ianwu0228/dc_lab_spring_2026/report/latex/figures/coil_driver_chain.jpg

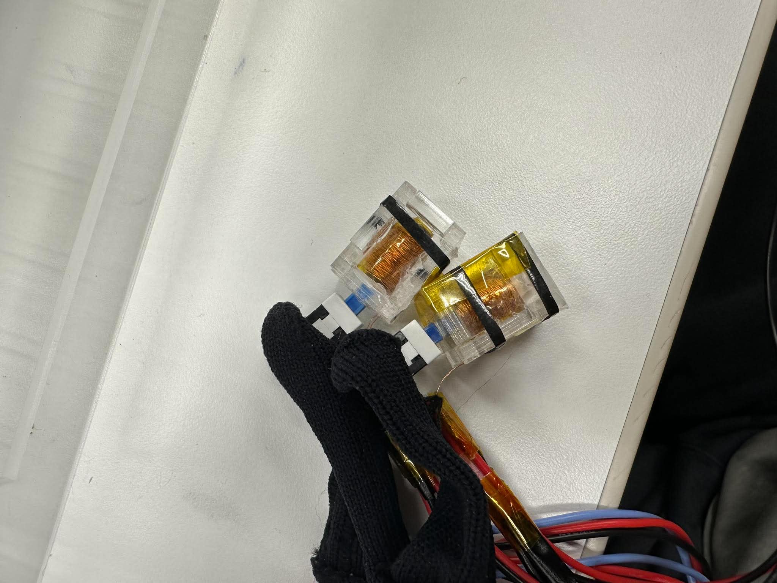
report/latex/figures/coil_driver_chain.jpg
