ianwu0228/dc_lab_spring_2026/report/latex/figures/final_hardware_photo.jpg

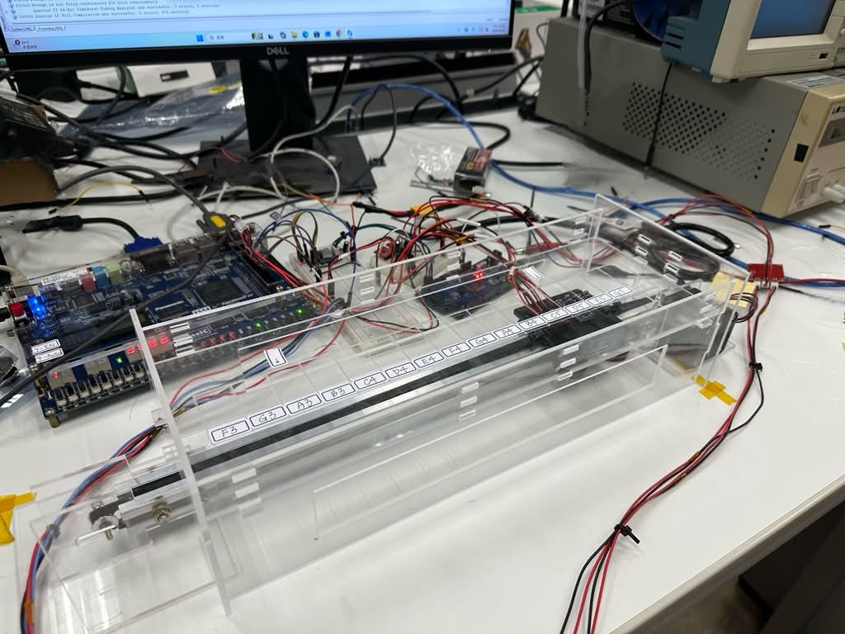
report/latex/figures/final_hardware_photo.jpg
