ianwu0228/dc_lab_spring_2026/report/latex_template/back/appendix01.tex

\section{Supplementary Derivations}
\label{app:supplementary_derivations}

Place longer derivations, additional simulation settings, or supporting tables
here. Keep the main report focused on the design story and move detailed backup
material to the appendix.
