ianwu0228/dc_lab_spring_2026/report/latex_template/contents/01_spec_summary.tex

\section{Specification Summary}
\label{sec:spec_summary}

Summarize the target specifications of Project 2 and report the final simulated
performance after the design is complete. Keep this table as the first technical
checkpoint so readers can quickly compare the requirement and implementation.

\begin{table}[H]
    \centering
    \caption{Project 2 specification summary.}
    \label{tab:spec_summary}
    \renewcommand{\arraystretch}{1.25}
    \begin{tabularx}{0.95\textwidth}{
        >{\raggedright\arraybackslash}X
        >{\centering\arraybackslash}p{3.2cm}
        >{\centering\arraybackslash}p{3.2cm}
        >{\centering\arraybackslash}p{2.4cm}
    }
        \toprule
        \textbf{Specification} & \textbf{Requirement} & \textbf{Result} & \textbf{Status} \\
        \midrule
        Supply voltage & TBD & TBD & TBD \\
        Input range & TBD & TBD & TBD \\
        Output range & TBD & TBD & TBD \\
        Operating frequency & TBD & TBD & TBD \\
        Power consumption & TBD & TBD & TBD \\
        Key performance metric 1 & TBD & TBD & TBD \\
        Key performance metric 2 & TBD & TBD & TBD \\
        \bottomrule
    \end{tabularx}
\end{table}

Briefly explain the most important design trade-offs and any specifications that
are close to the requirement limit.
