ianwu0228/dc_lab_spring_2026/report/latex_template/contents/02_system_architecture.tex

\section{System Architecture}
\label{sec:system_architecture}

Describe the top-level architecture of the Project 2 circuit. State the role of
each major block and explain how signals flow from the input to the output.

\begin{figure}[H]
    \centering
    \fbox{\parbox[c][5cm][c]{0.85\textwidth}{
        \centering
        Replace this box with the top-level architecture figure.
    }}
    \caption{Top-level architecture of the Project 2 design.}
    \label{fig:system_architecture}
\end{figure}

\subsection{Block Overview}

List the main blocks in the system and summarize their functions. For each block,
include the design intent, critical interfaces, and any important assumptions.

\begin{itemize}
    \item \textbf{Block 1:} Describe its purpose and input/output signals.
    \item \textbf{Block 2:} Describe its purpose and input/output signals.
    \item \textbf{Block 3:} Describe its purpose and input/output signals.
\end{itemize}

\subsection{Operation Sequence}

Explain the operating phases, timing sequence, or control flow used by the design.
Use a timing diagram if the project depends on clock phases, reset behavior, or
state transitions.
