ianwu0228/dc_lab_spring_2026/report/latex/magnetic_piano_top_level_architecture.pptx

Top-level System Architecture - Magnetic Piano (75Hz / 45Hz Detection & Auto-Tracking Platform)

FPGA (Intel DE2-115)

QMC5883P Magnetometers

3-axis magnetic sensors
I2C-line interface (GPIO)
Data rate: 200 Hz
Output: 16-bit raw X, Y, Z

1. Sensor Readout (I2C)

qmc5883p_ctrl (x3)

Init & register config
Periodic readout
Data assembly

Raw Data Outputs

mag1_x/y/z
mag2_x/y/z
mag3_x/y/z

2. Calibration

(for average & scale calc)

mag_calibration_manager

Compute offset & radius

Calibration Coefficients

3. Real-time Calibration

mag_calibrator (x3)

Calibrated Outputs

sample_tick

Sample Sync
& Tick

sample_seen
mask

All active
sensors
updated?

carrier_
sample_tick

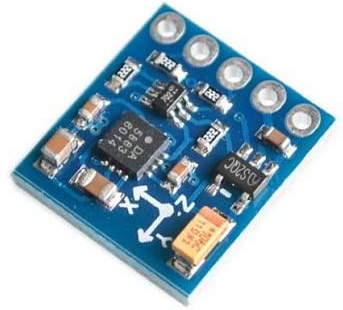
[picture p3: figure]
QMC5883P 3-Axis Compass Magnetometer Sensor Module 3V-5V - QMC5883PMOD

i2c_master (x3)

Raw Data

unsigned_divider

coeff.

Real time
H2 value

PC (Windows)

Python Application
Receive via UART
LUT Collection
Piano Key Monitor
(H2 Frames & KEY Frames)

4. Reference Generators(Fs = 200 Hz)

5. Lock-in Detection (Per-Sensor)

Multiply with sin75/cos75
I/Q accumulation
H2 = X1^2 + Y1^2 + Z1^2

Calibrated field

mag_lockin_vector_75hz (x3)

Multiply with sin45/cos45
I/Q accumulation
H2 = X1^2 + Y1^2 + Z1^2

Outputs

H45_S1,H45_S2, H45_S3

10. UART Streaming to PC

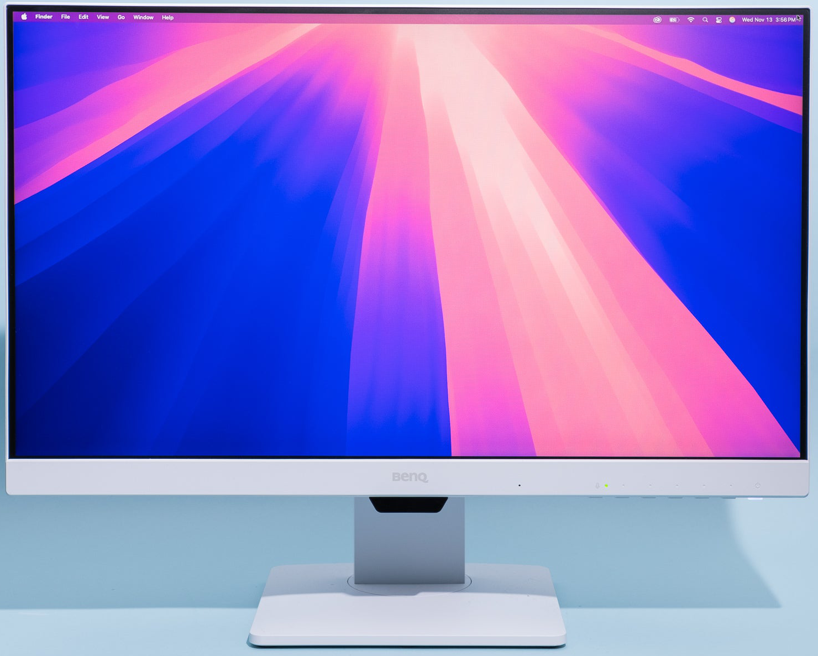
[picture p4: figure]
The 8 Best Monitors of 2026 | Reviews by Wirecutter

Reference-75hz

75 Hz = 3/8 cycle
8-entry LUT

Reference_45hz

45 Hz =9/40 cycle
40-entry LUT

mag_lockin_vector_75hz (x3)

Outputs

H75_S1, H75_S2, H75_S3

UART_TXD

Press Buttons (Active-High)

Button 0 –
75Hz Note
-> GPIO[11]

Button 1 –
45Hz Note
-> GPIO[12]

Debounced (10 ms)
Sent to PC as press state

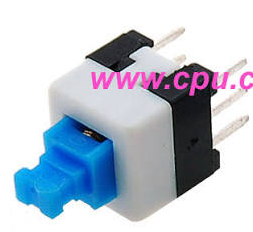
[picture p5: figure]
KPA-2203A 7x7mm 6P無段按鍵開關| 廣華電子

GPIO[11]
GPIO[12]

Outputs

sin75_q15
cos75_q15

Outputs

sin45_q15
cos45_q15

H2 frames

sin/cos q15

6. H2 Frame Averaging (Noise Smoothing)

7. LUT-based Classification (Per Frequency)

h2_lut_classifier_3sensor

Compute ratios
Compare with LUT ROM

key75_id, key75_score, key75_valid
key45_id, key45_score, key45_valid

8. Platform Tracker (Auto-Follow)

Decision:
sum <= -2 -> move left
sum >= +2 -> move right
otherwise -> stay
Boundary check (K2 ~ K12)
Stable confirmation & cooldown

9. Stepper Control (FPGA)

stepper_drv8825_controller

Outputs

Step/DIR/EN

DRV8825
Stepper Driver

Microstep (1/16)
VMOT / GND
A1/A2, B1/B2

h2_average_3sensor
(for 75Hz)

h2_average_3sensor
(for 45Hz)

avg_H2

unsigned_divider

Outputs

key75/key45

STEP / DIR
EN

LUT

Stepper Motor
(NEMA17)

Display & Debug (On FPGA)

Show raw/calibrated values, H2 (75/45), keys, platform center, status

VGA

LCD 16x2

7-Segment HEX

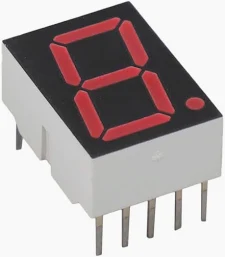
[picture p6: figure]

LEDR

LEDG

FPGA External Interface Summary

I2C-like (GPIO):
SCL1/SDA1 -> Sensor #1
SCL2/SDA2 -> Sensor #2
SCL3/SDA3 -> Sensor #3
Buttons: GPIO[11] (75Hz), GPIO[12] (45Hz)
Stepper Driver: GPIO[8] STEP, GPIO[9] DIR, GPIO[10] ENABLE_N
UART: RS232 TXD -> PC (115200 bps)

LUT Memory Files

Stored in FPGA ROM via .mem files
h75_lut_3sensor.
h45_lut_3sensor.mem

Legend

Data Path

Control / Timing

Power / Mechanical

Sliding Platform / Bottom

Moves Left <-> Right

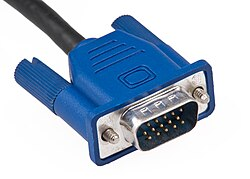
[picture p7: figure]
VGA端子- 維基百科，自由的百科全書
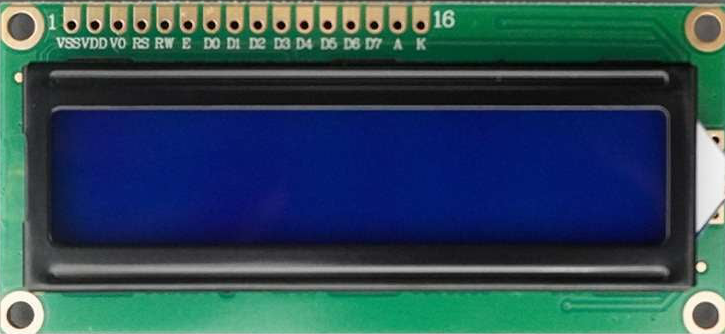
[picture p8: figure]
Sensors Modules Lcd 16x2 Display Module | Sensors Modules

Motor Control

UART
