ianwu0228/dc_lab_spring_2026/team07_final/presentation_slides.pdf

# DCLab Final

# Magnetic Field Finger-Tracking Musical Glove

2026 Spring

### Group 7 電機四 B11202010 韓裕民、B11901188 吳毅恩、B11901193 劉又慈

## - Hardware Implementation

## - FPGA System Architecture

## - Filtering Strategy

## - Key Classification

# Outline

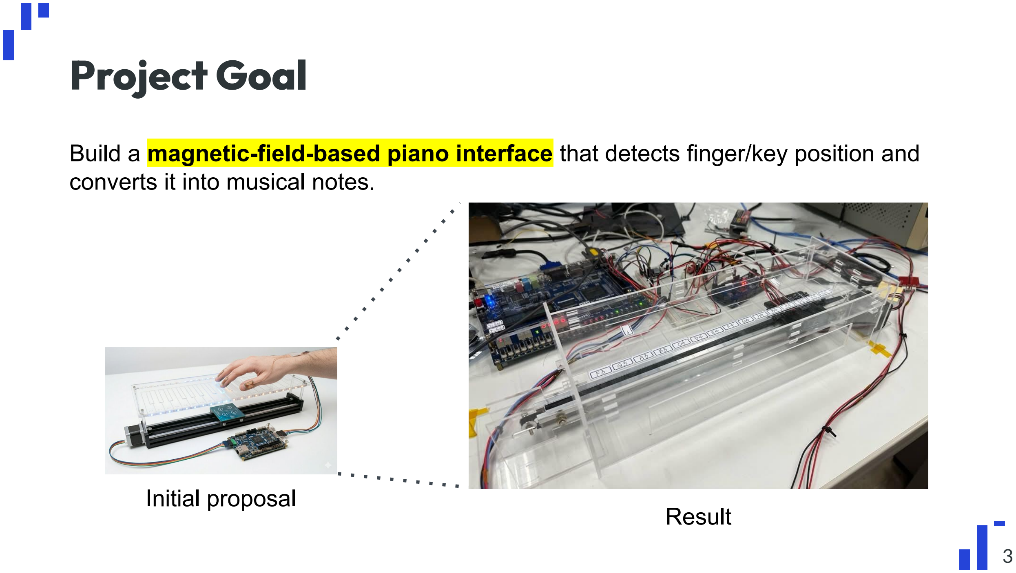
[picture p17: figure]
Initial proposal; converts it into musical notes.; Project Goal; Result

Build a magnetic-field-based piano interface that detects finger/key position and

# Hardware Implementation

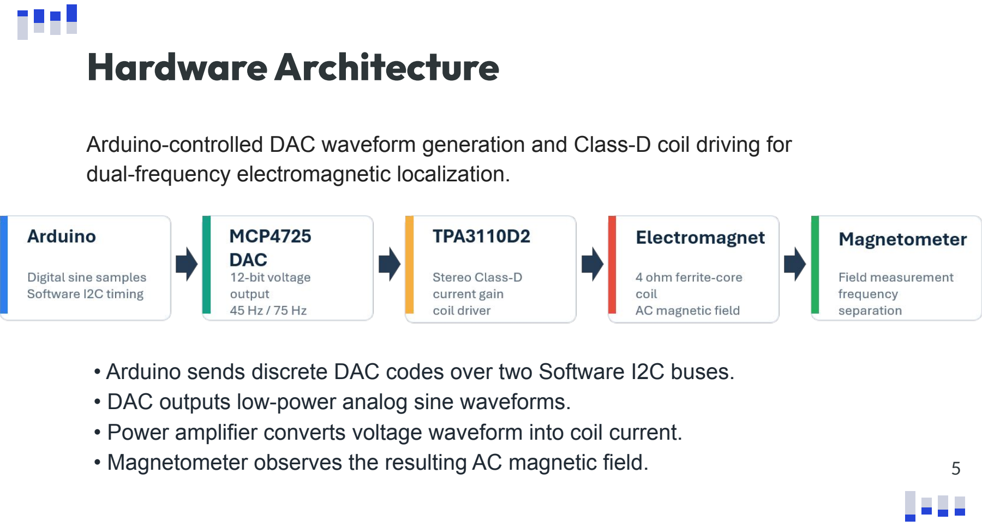
[picture p18: figure]
Hardware Architecture

Arduino-controlled DAC waveform generation and Class-D coil driving for dual-frequency electromagnetic localization.

- Arduino sends discrete DAC codes over two Software I2C buses.
- DAC outputs low-power analog sine waveforms.
- Power amplifier converts voltage waveform into coil current.
- Magnetometer observes the resulting AC magnetic field.

# Electromagnet design

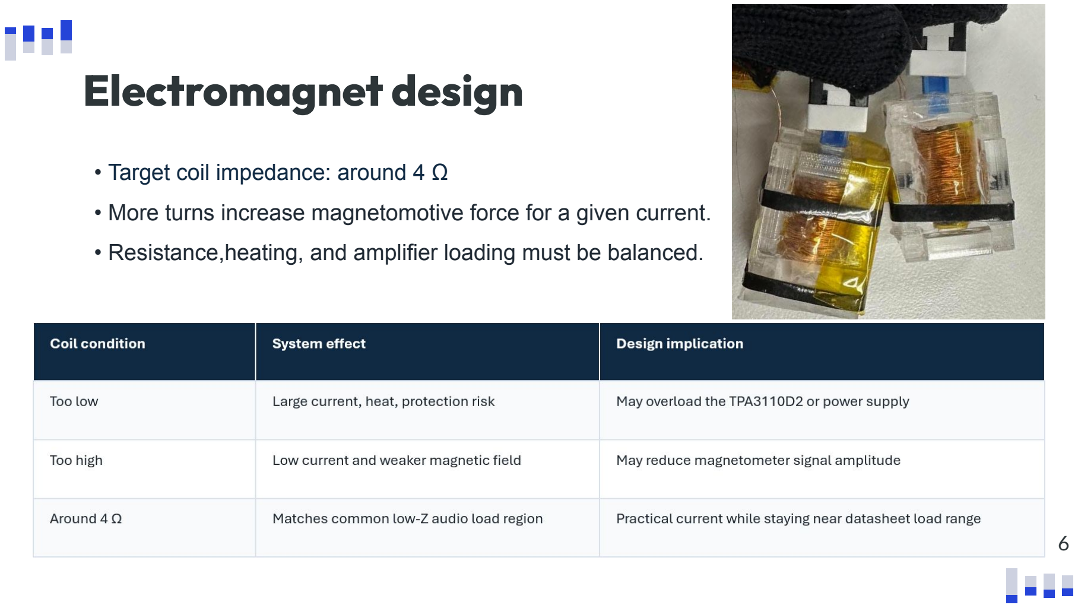
[picture p19: page 6]

6

- Target coil impedance: around 4 Ω
- More turns increase magnetomotive force for a given current.
- Resistance,heating, and amplifier loading must be balanced.

# DAC – MCP4725

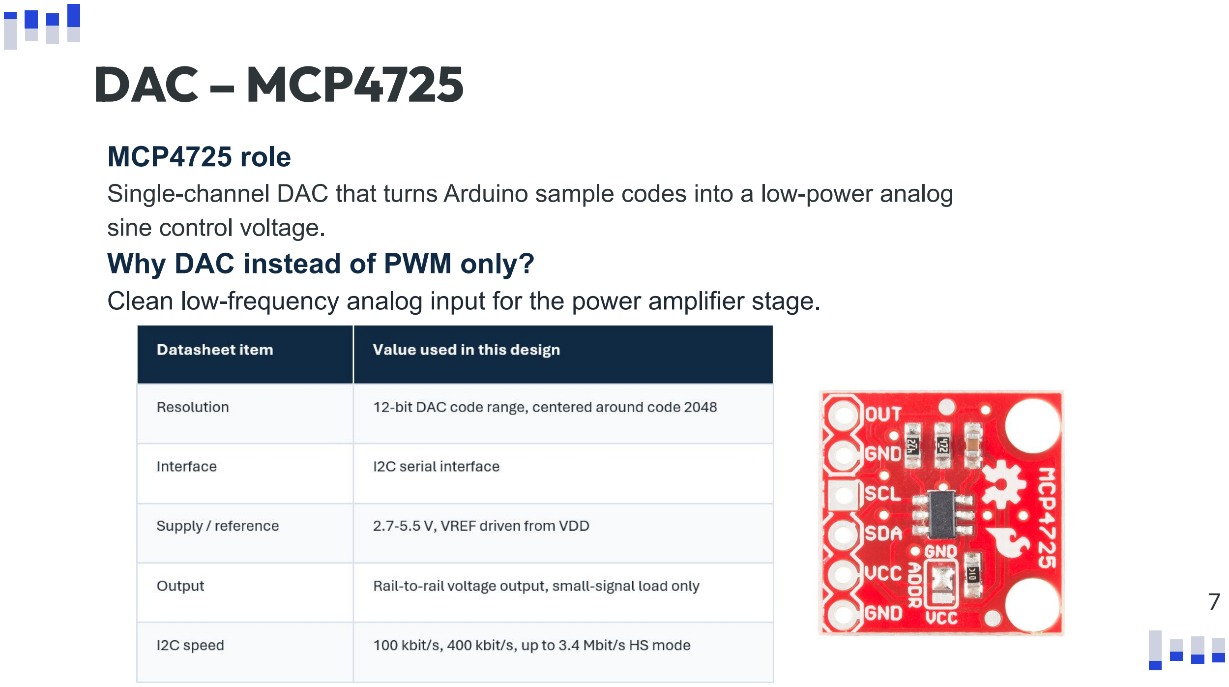
[picture p20: page 7]

7

MCP4725 role
Single-channel DAC that turns Arduino sample codes into a low-power analog sine control voltage.
Why DAC instead of PWM only?
Clean low-frequency analog input for the power amplifier stage.

# Power Amp – TPA3110D2

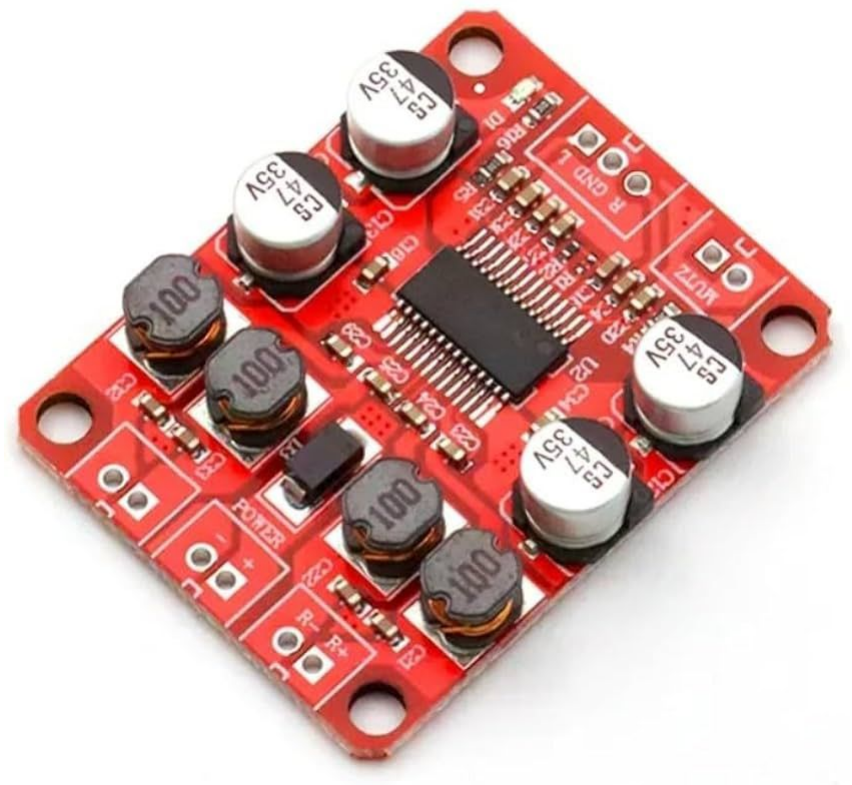
[picture p21: figure]

8

TPA3110D2 role

DAC output is a control voltage; the coil requires power current -> Power Amp Why do we choose TPA3110D2?

- Two channels for two coil frequencies.
- Matches approximate coil impedance target.

# Dual-Frequency Magnetic Field Encoding

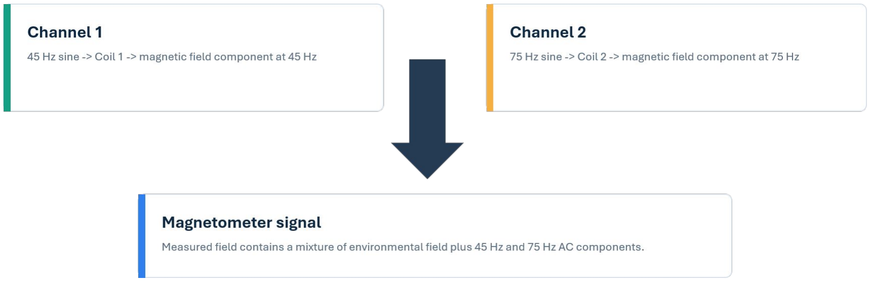
[picture p22: figure]

9

# FPGA System Architecture

# System Overview

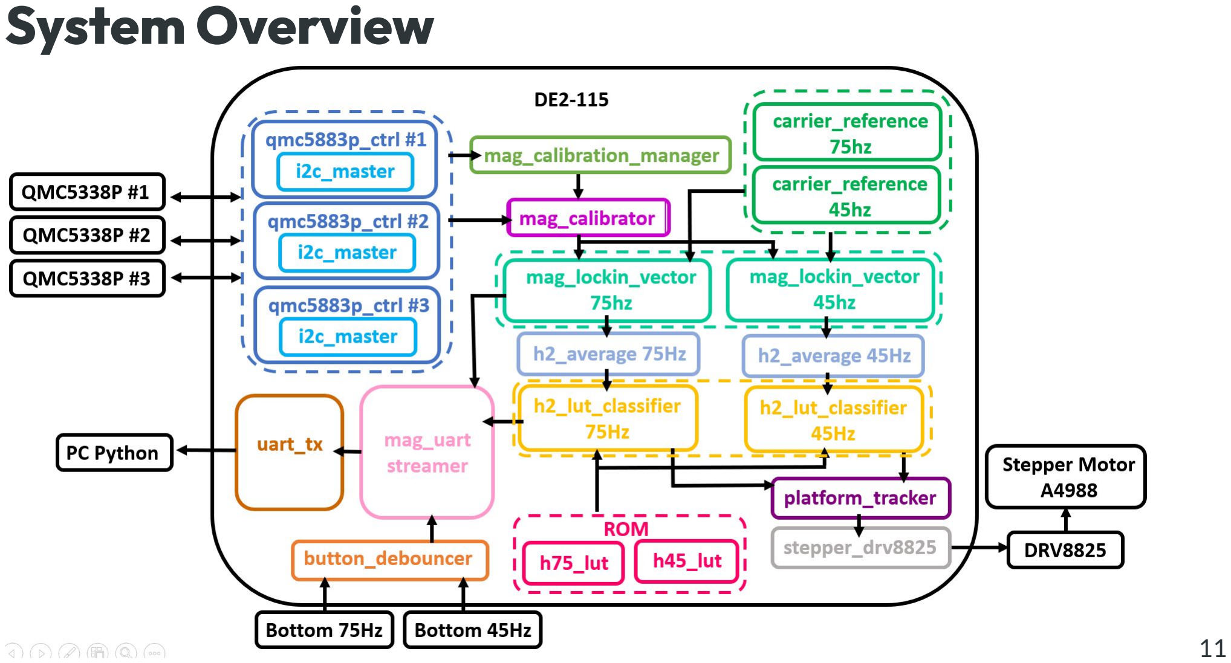
[picture p23: page 11]

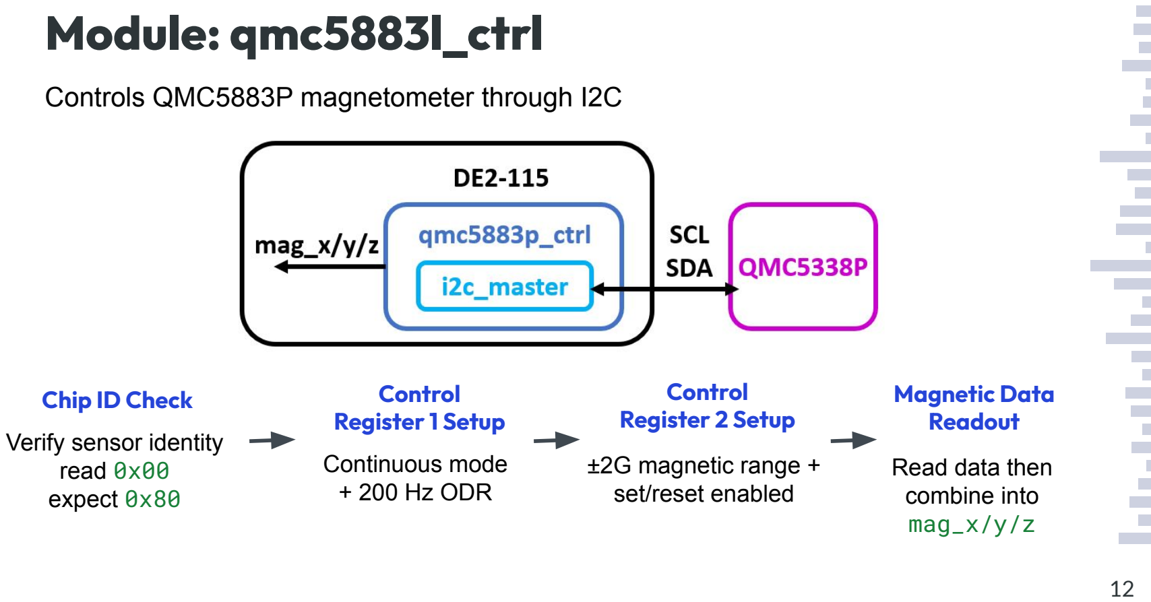
[picture p24: figure]
Module: qmc5883l_ctrl; Chip ID Check; Control; Register 2 Setup; Magnetic Data Readout; Verify sensor identity read 0x00 expect 0x80; Continuous mode + 200 Hz ODR; ±2G magnetic range + set/reset enabled; Control Register 1 Setup; Read data then combine into mag_x/y/z

Controls QMC5883P magnetometer through I2C

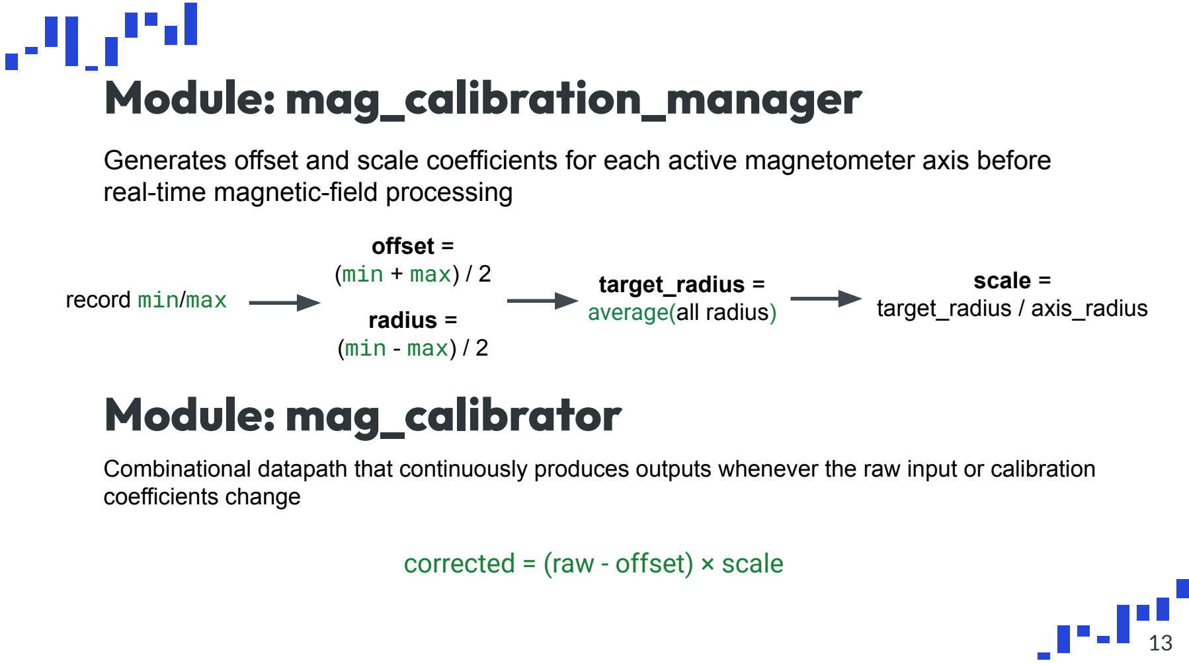
[picture p25: figure]
Module: mag_calibration_manager; real-time magnetic-field processing; record min/max; offset = (min + max) / 2; radius = (min - max) / 2; target_radius = average(all radius); scale = target_radius / axis_radius; Module: mag_calibrator; corrected = (raw - offset) × scale; coefficients change

Generates offset and scale coefficients for each active magnetometer axis before

Combinational datapath that continuously produces outputs whenever the raw input or calibration

# Module: unsigned_divider

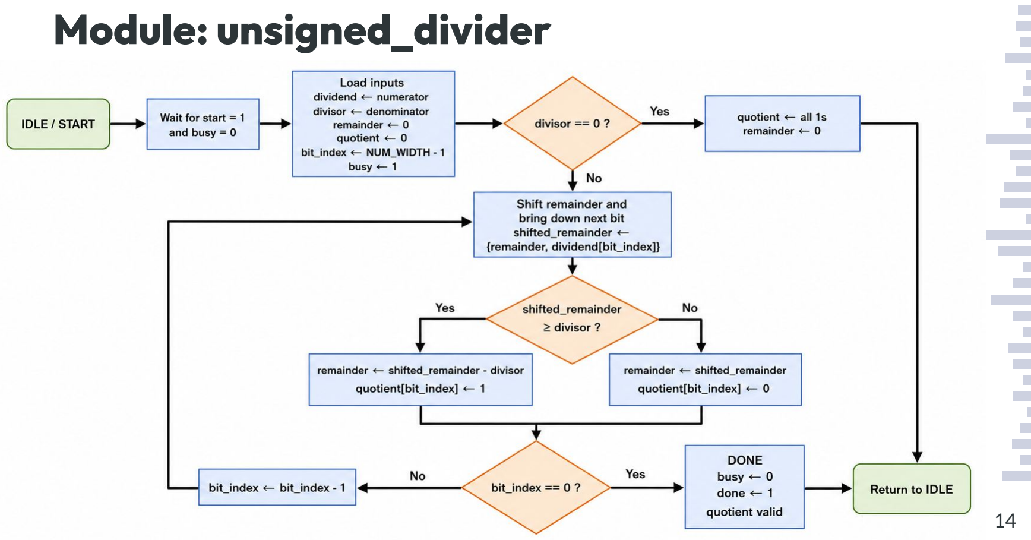
[picture p26: page 14]

# Filtering Strategy

# Core Idea

The calibrated magnetic signal is multiplied by a 75/45 Hz sine/cosine reference and accumulated over a window

➔ | 75/45 Hz component accumulates coherently
➔ | DC component, noise and other frequencies tend to cancel
➔ | Output represents the detected 75/45 Hz magnetic-field strength

carrier_reference_75hz: generates 75/45 Hz sine/cosine reference mag_lockin_vector_75hz: performs lock-in filtering and energy computation

# Module: carrier_reference_75hz

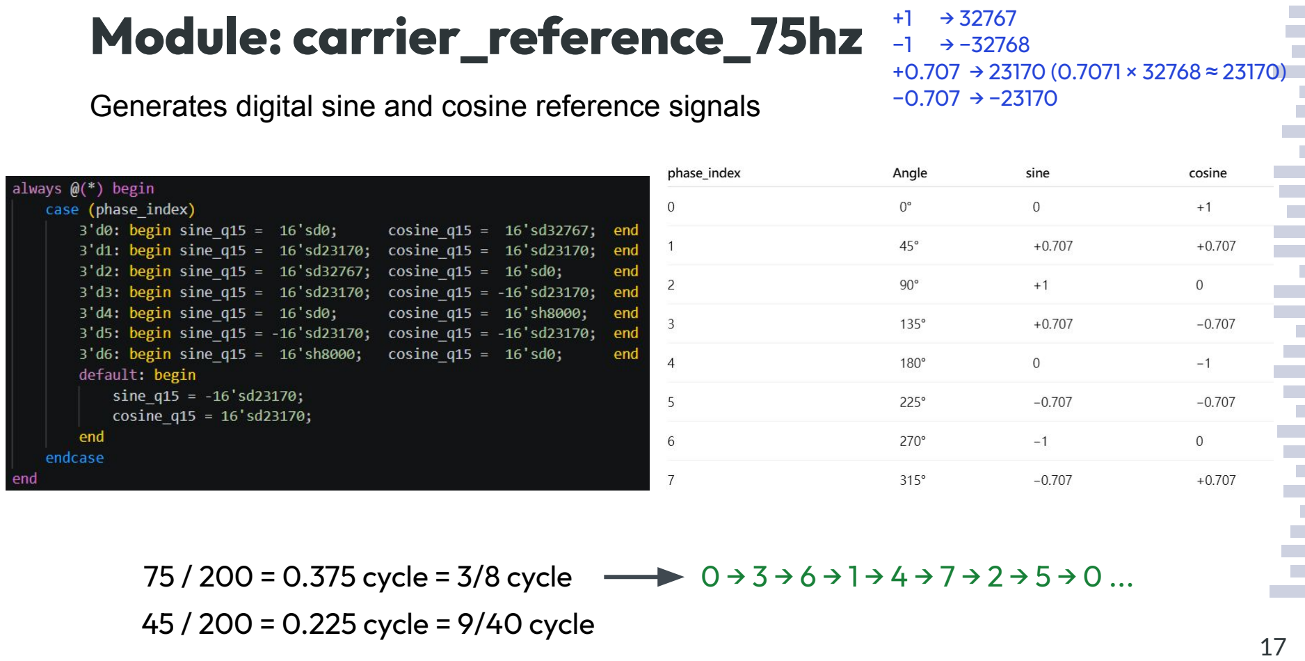
[picture p27: page 17]

Generates digital sine and cosine reference signals

75 / 200 = 0.375 cycle = 3/8 cycle | 0 → 3 → 6 → 1 → 4 → 7 → 2 → 5 → 0 ...
+1 | → 32767
−1 | → −32768
+0.707 | → 23170 (0.7071 × 32768 ≈ 23170)
−0.707 | → −23170

### 45 / 200 = 0.225 cycle = 9/40 cycle

# Module: mag_lockin_vector_75hz

Extracts the 75 Hz magnetic-field component from the calibrated X/Y/Z data

Multiply with 75 Hz Reference | both sin and cos insensitive to phase difference

Accumulate over 100 Samples

The module sums these I/Q products over a 100-sample rolling window:

I_acc | = sum(signal × cos_ref)
Q_acc = sum(signal × sin_ref) | acc_new = acc_old + new_product - old_product

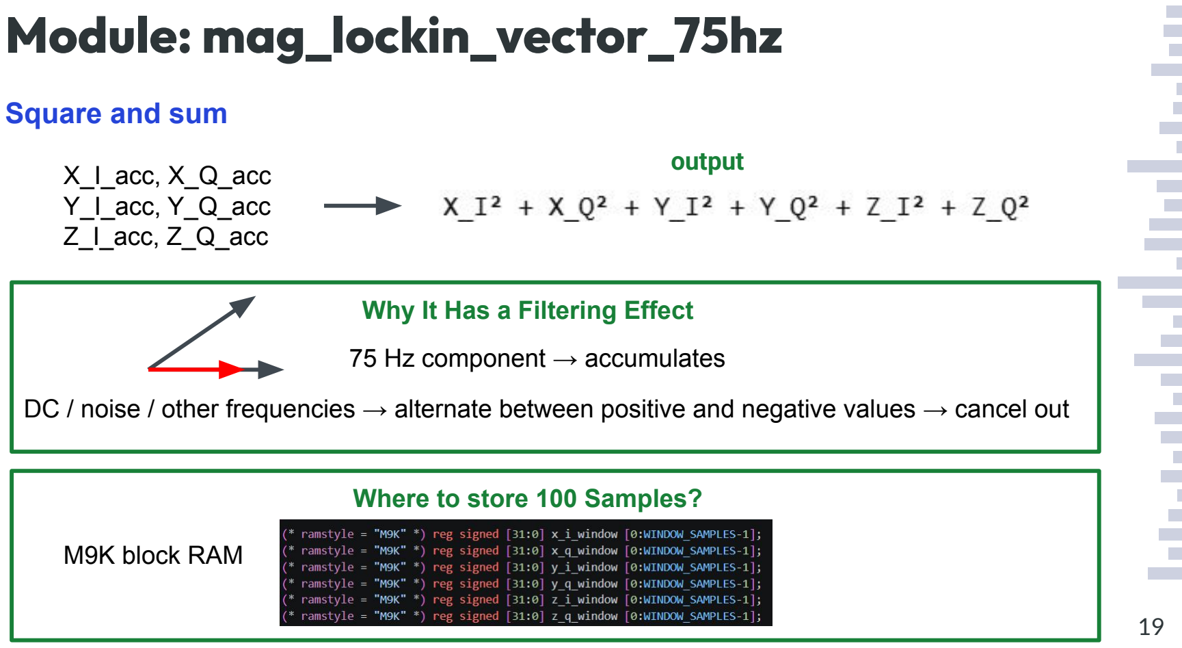
[picture p28: figure]
Module: mag_lockin_vector_75hz; Square and sum; output X_I_acc, X_Q_acc; Y_I_acc, Y_Q_acc Z_I_acc, Z_Q_acc; Why It Has a Filtering Effect; 75 Hz component → accumulates; Where to store 100 Samples?; M9K block RAM

DC / noise / other frequencies → alternate between positive and negative values → cancel out

# Key Classification

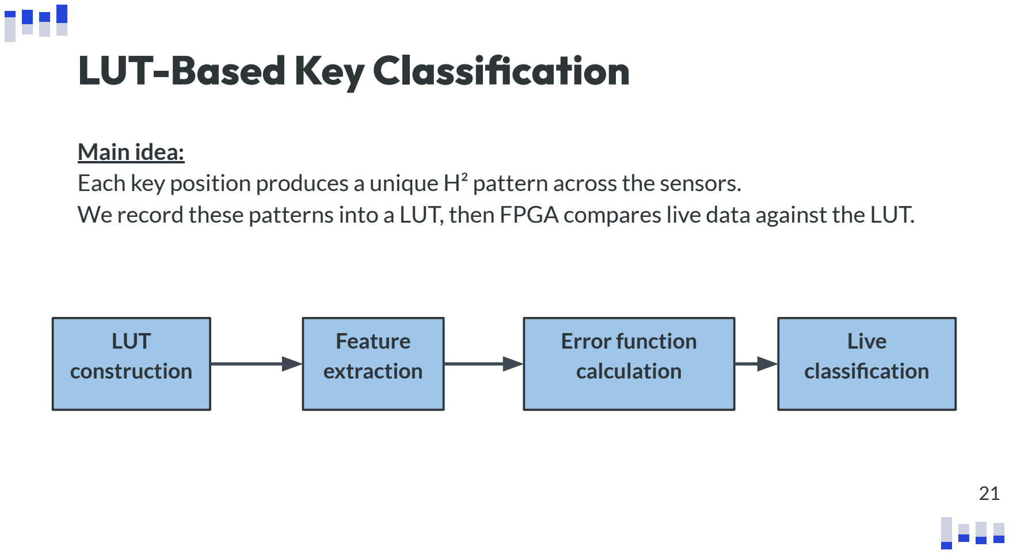
[picture p29: figure]
LUT-Based Key Classification; Main idea:; LUT construction; Feature extraction; Error function calculation; Live classification

Each key position produces a unique H² pattern across the sensors.
We record these patterns into a LUT, then FPGA compares live data against the LUT.

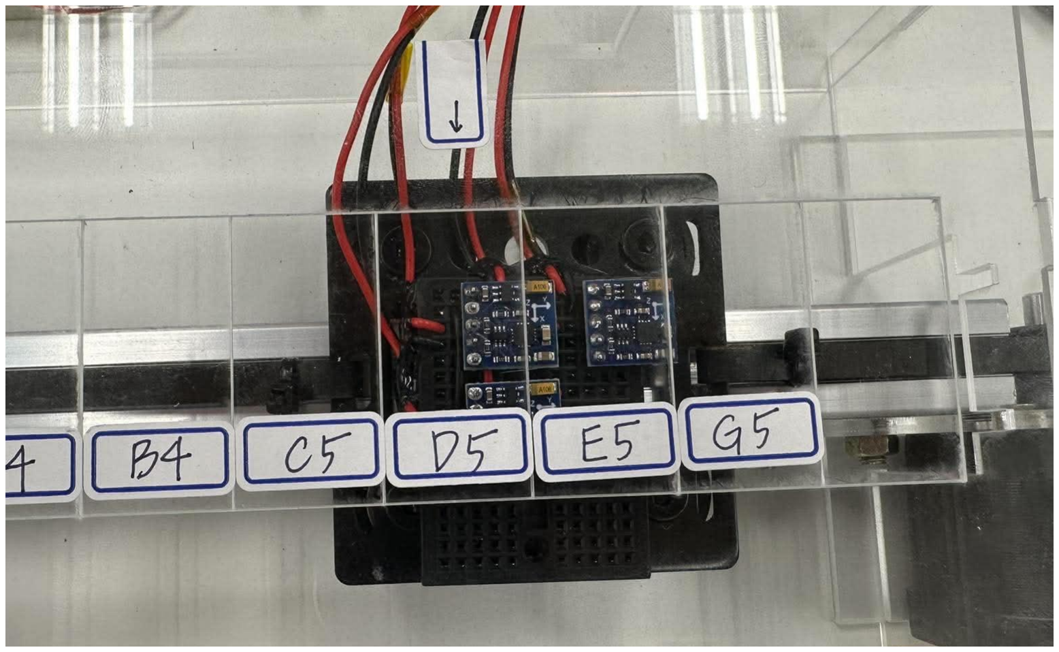
[picture p30: figure]
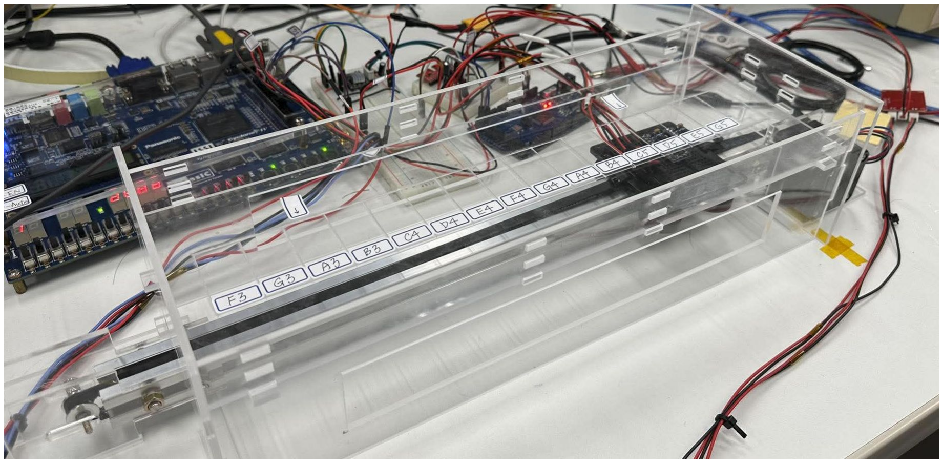
[picture p31: figure]

# LUT Construction

- 15 piano keys.
- 3 sensors (magnetometers).

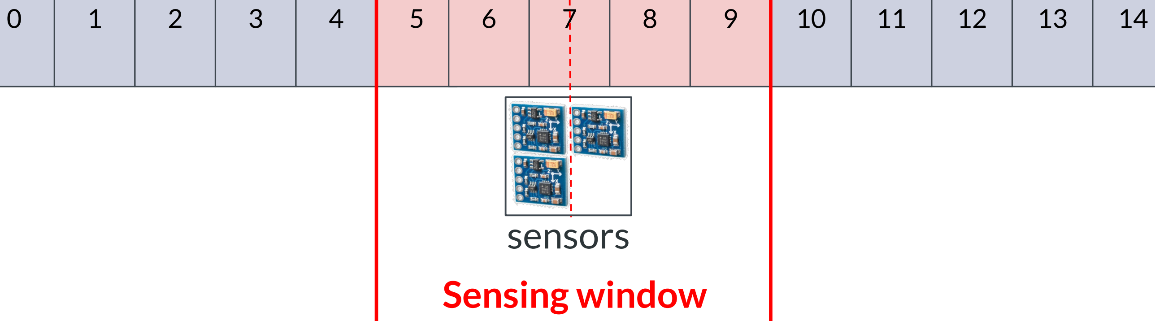
[picture p32: figure]
Sensing window; sensors

22

Key’s
global index
Local | index
-2 | -1 | 0 | 1 | 2

global _index = platform_center_global + local_index

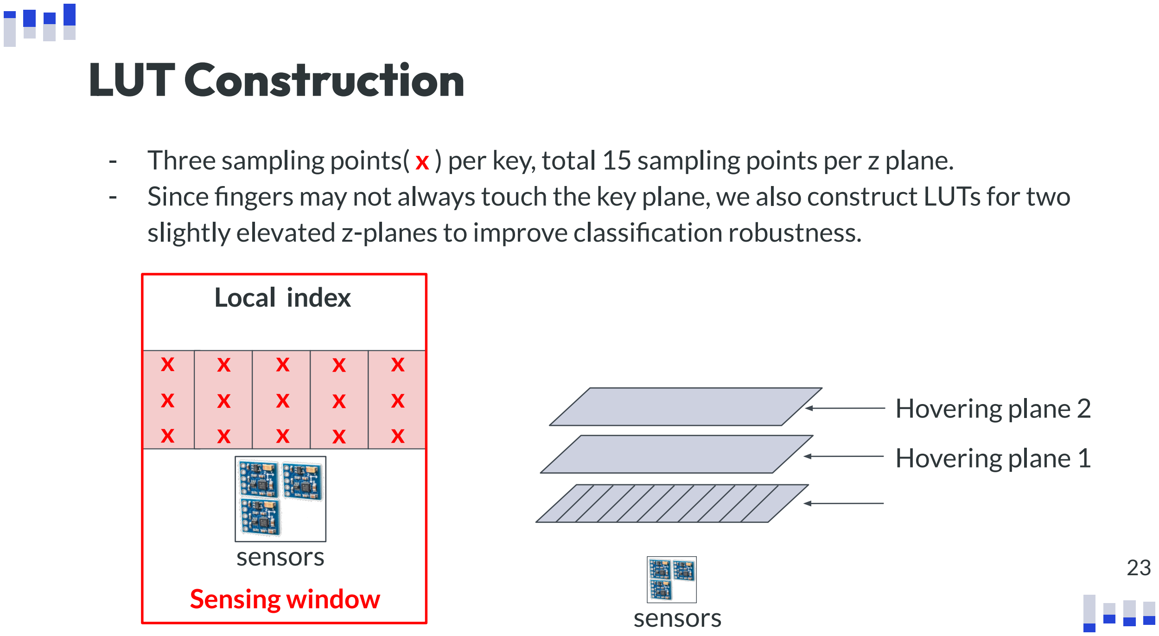
[picture p33: figure]
LUT Construction; Local; index; Sensing window; sensors; Hovering plane 1; Hovering plane 2 x x

- Three sampling points( x ) per key, total 15 sampling points per z plane.
- Since fingers may not always touch the key plane, we also construct LUTs for two slightly elevated z-planes to improve classification robustness.

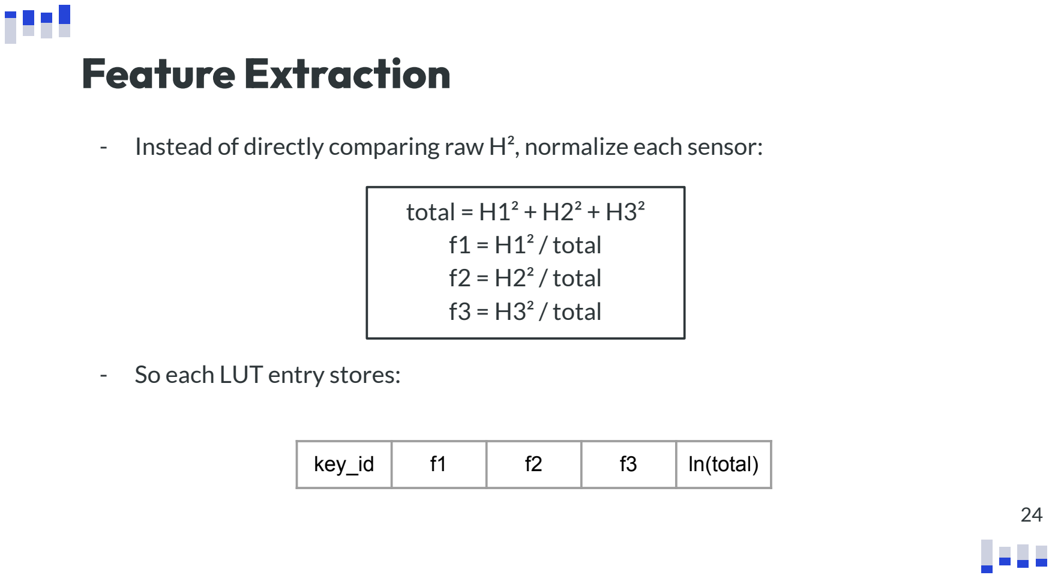
[picture p34: figure]
Feature Extraction; - So each LUT entry stores:; total = H1² + H2² + H3² f1 = H1² / total f2 = H2² / total f3 = H3² / total; key_id; ln(total)

- Instead of directly comparing raw H², normalize each sensor:

# Why Normalize H²?

- Raw H² compares “how strong the signal is.”
- Normalized H² compares “which sensor is strongest relative to the others.”
- Position is better represented by the relative sensor pattern.
- Normalization removes scale.
- Final error keeps a small strength term.

25

# Error Function / Live Classification

26

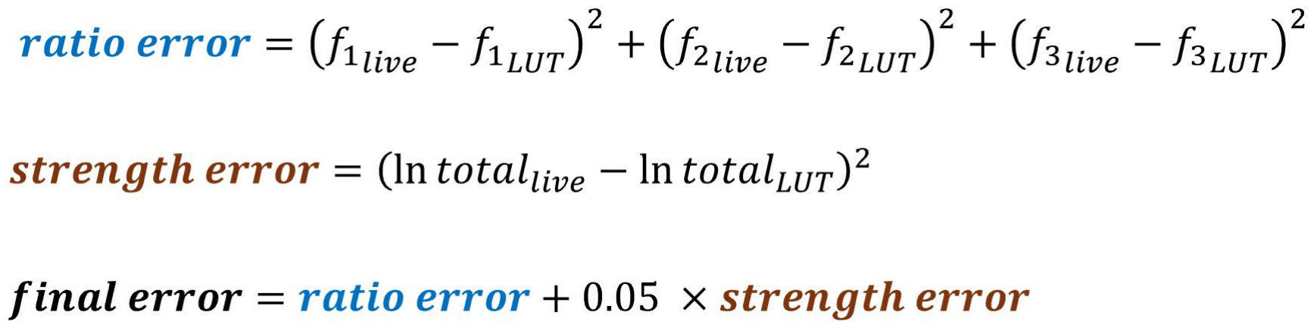
[picture p35: figure]

Predicted key = key with minimum final error

# Stepper Motor Auto-Tracking Control Algorithm

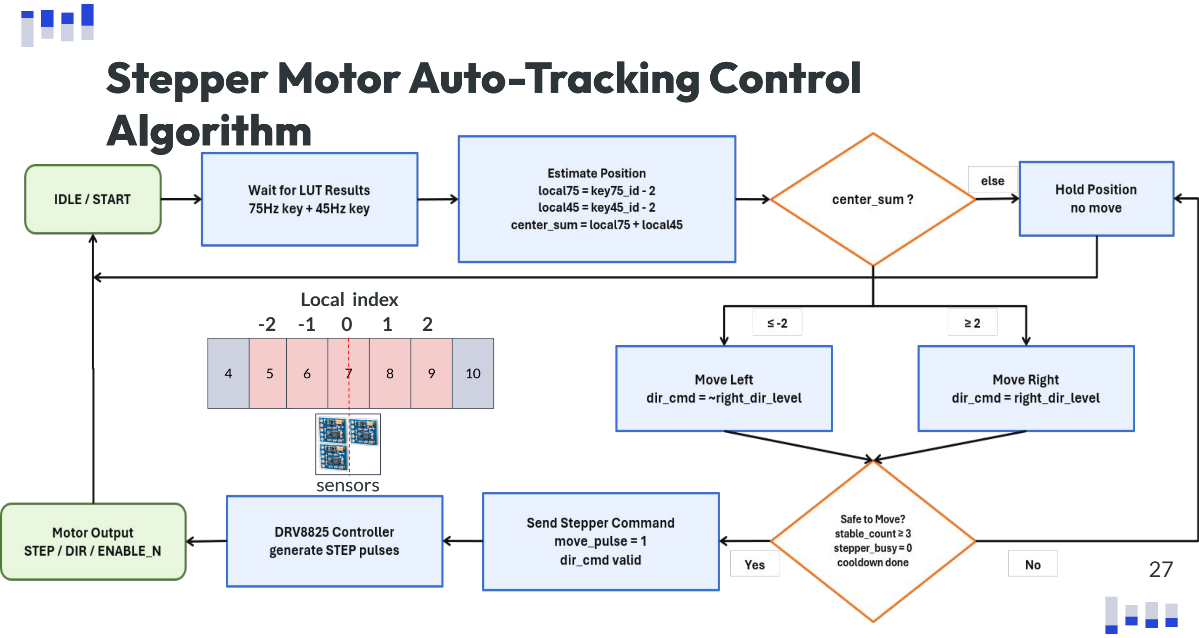
[picture p36: page 27]

27

4 | 5 | 6 | 7 | 8 | 9 | 10
Local | index
| -2 | -1 | 0 | 1 | 2

sensors

# Thanks!

28
