ianwu0228/dc_lab_spring_2026/report/latex/figures/lut_sampling.png

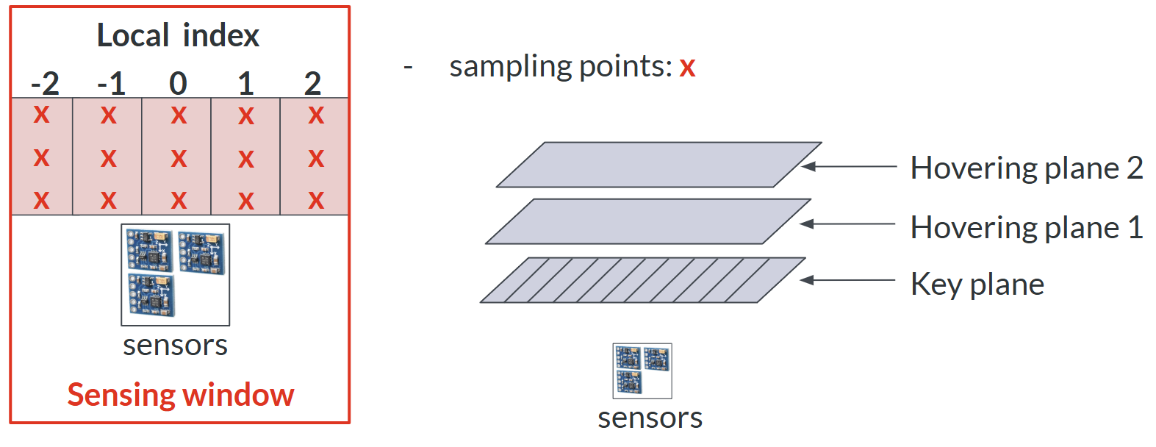
report/latex/figures/lut_sampling.png
