ianwu0228/dc_lab_spring_2026/report/latex/figures/piano_gui_update.png

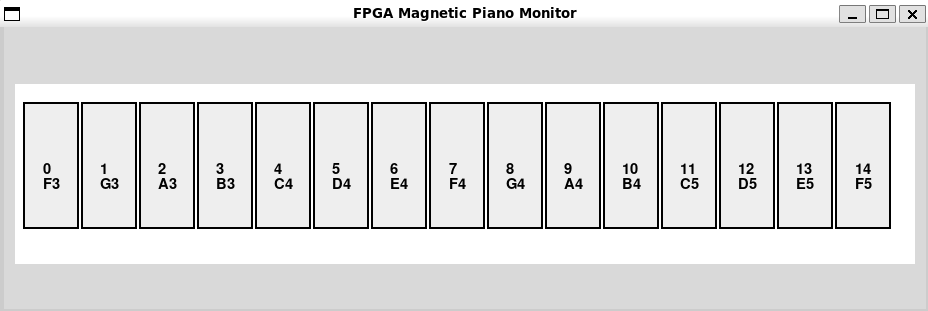
report/latex/figures/piano_gui_update.png
