ianwu0228/dc_lab_spring_2026/report/latex/figures/system_block_diagram.png

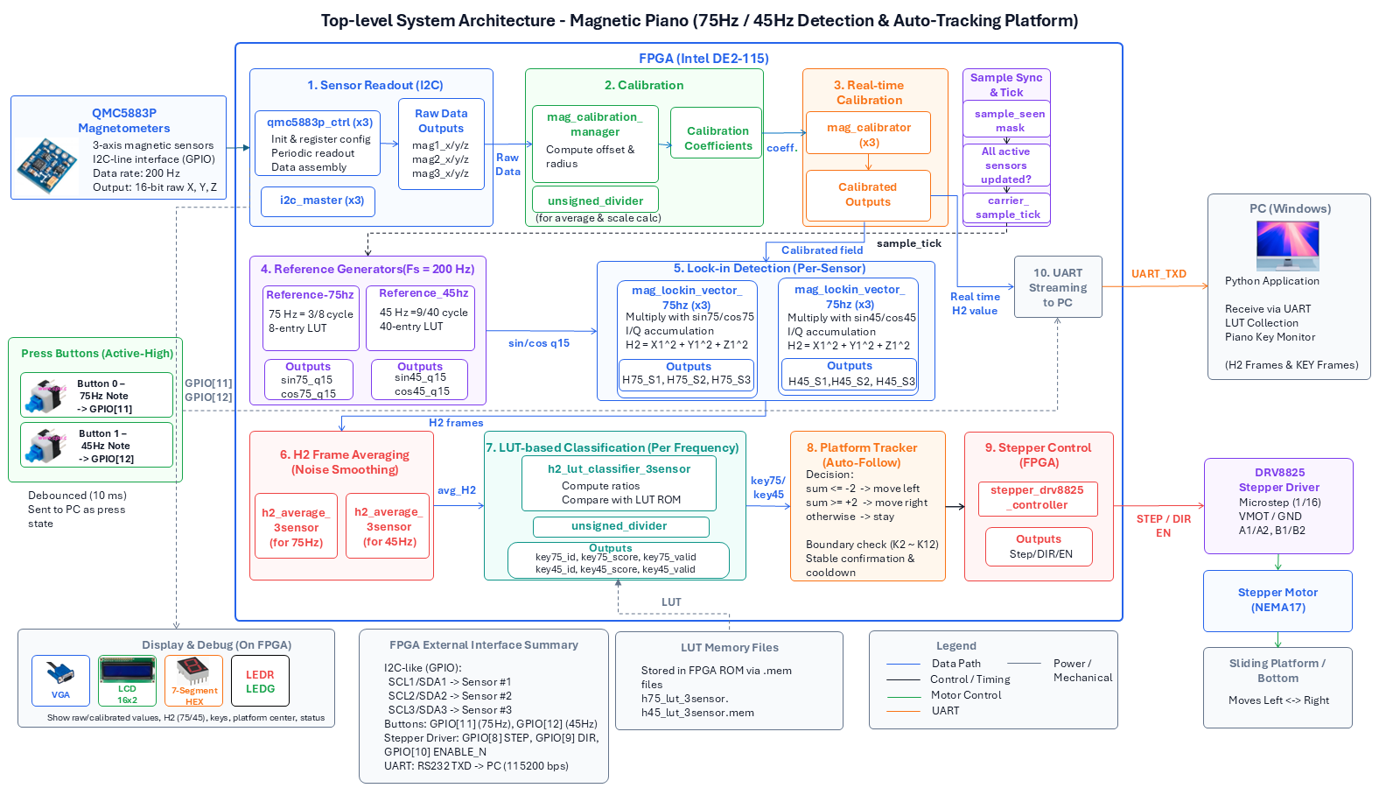
report/latex/figures/system_block_diagram.png
