ianwu0228/dc_lab_spring_2026/team07_final/src_python/read_mag_uart.py

#!/usr/bin/env python3
import argparse
from collections import deque
import csv
import math
import re
import sys
import time

try:
    import serial
except ImportError:
    print("Missing dependency: pyserial. Install with: pip install pyserial", file=sys.stderr)
    raise


LINE_RE = re.compile(
    r"^S(?P<sensor>[1-3]) "
    r"X=(?P<x>[+-][0-9A-Fa-f]{4}) "
    r"Y=(?P<y>[+-][0-9A-Fa-f]{4}) "
    r"Z=(?P<z>[+-][0-9A-Fa-f]{4})$"
)


def signed_hex_to_int(value: str) -> int:
    sign = -1 if value[0] == "-" else 1
    return sign * int(value[1:], 16)


def parse_line(line: str):
    match = LINE_RE.match(line)
    if not match:
        return None

    return {
        "sensor": int(match.group("sensor")),
        "x": signed_hex_to_int(match.group("x")),
        "y": signed_hex_to_int(match.group("y")),
        "z": signed_hex_to_int(match.group("z")),
        "raw_line": line,
    }


class LivePlot:
    def __init__(self, window_seconds: float, absolute: bool, normalize: bool):
        try:
            import matplotlib.pyplot as plt
        except ImportError:
            print(
                "Missing dependency: matplotlib. Install with: pip install matplotlib",
                file=sys.stderr,
            )
            raise

        self.plt = plt
        self.window_seconds = window_seconds
        self.absolute = absolute
        self.normalize = normalize
        self.start_time = time.time()
        self.history = {
            sensor: {
                "t": deque(),
                "mag2": deque(),
            }
            for sensor in range(1, 4)
        }
        self.baseline = {sensor: None for sensor in range(1, 4)}

        plt.ion()
        self.figure, self.axis = plt.subplots(1, 1, figsize=(10, 6))
        self.lines = {}

        for sensor in range(1, 4):
            self.lines[sensor] = self.axis.plot([], [], label=f"S{sensor}")[0]

        title = "Magnetic Field Magnitude Squared"
        if self.normalize:
            title = "Magnetic Field Magnitude Squared Change Ratio"
        elif not self.absolute:
            title = "Magnetic Field Magnitude Squared Change"
        self.axis.set_title(title)
        self.axis.set_xlabel("Time (s)")
        if self.normalize:
            self.axis.set_ylabel("Delta from baseline / baseline")
        elif self.absolute:
            self.axis.set_ylabel("X^2 + Y^2 + Z^2 (counts^2)")
        else:
            self.axis.set_ylabel("Delta from baseline (counts^2)")
        self.axis.grid(True)
        self.axis.legend(loc="upper right")
        self.figure.tight_layout()
        self.figure.show()

    def add_sample(self, parsed):
        now = time.time() - self.start_time
        sensor = parsed["sensor"]
        mag2 = parsed["x"] ** 2 + parsed["y"] ** 2 + parsed["z"] ** 2
        if self.baseline[sensor] is None:
            self.baseline[sensor] = mag2

        if self.normalize:
            baseline = max(self.baseline[sensor], 1)
            plot_value = (mag2 - baseline) / baseline
        elif self.absolute:
            plot_value = mag2
        else:
            plot_value = mag2 - self.baseline[sensor]

        values = self.history[sensor]
        values["t"].append(now)
        values["mag2"].append(plot_value)

        cutoff = now - self.window_seconds
        while values["t"] and values["t"][0] < cutoff:
            values["t"].popleft()
            values["mag2"].popleft()

    def update(self):
        now = time.time() - self.start_time
        x_min = max(0.0, now - self.window_seconds)
        x_max = max(self.window_seconds, now)
        visible_values = []

        for sensor in range(1, 4):
            values = self.history[sensor]
            times = list(values["t"])
            mag2_values = list(values["mag2"])
            self.lines[sensor].set_data(times, mag2_values)
            visible_values.extend(mag2_values)

        self.axis.set_xlim(x_min, x_max)

        if visible_values:
            ymin = min(visible_values)
            ymax = max(visible_values)
            if not math.isfinite(ymin) or not math.isfinite(ymax):
                ymin, ymax = -1.0, 1.0

            span = ymax - ymin
            if self.normalize:
                min_span = 0.05
            elif self.absolute:
                min_span = 1000.0
            else:
                min_span = 1000.0

            if span < min_span:
                center = (ymin + ymax) / 2
                ymin = center - min_span / 2
                ymax = center + min_span / 2
            else:
                padding = span * 0.1
                ymin -= padding
                ymax += padding

            self.axis.set_ylim(ymin, ymax)

        self.figure.canvas.draw_idle()
        self.plt.pause(0.001)


def main() -> int:
    parser = argparse.ArgumentParser(
        description="Read three-sensor magnetometer data from FPGA RS232 UART."
    )
    parser.add_argument(
        "port",
        help="Serial port, e.g. COM3 on Windows or /dev/ttyUSB0 on Linux.",
    )
    parser.add_argument("--baud", "-baud", type=int, default=115200)
    parser.add_argument("--csv", help="Optional CSV output file.")
    parser.add_argument(
        "--print-raw",
        action="store_true",
        help="Print raw serial lines instead of parsed decimal values.",
    )
    parser.add_argument(
        "--plot",
        action="store_true",
        help="Plot live X^2+Y^2+Z^2 traces for all three sensors.",
    )
    parser.add_argument(
        "--plot-window",
        type=float,
        default=5.0,
        help="Live plot time window in seconds.",
    )
    parser.add_argument(
        "--plot-update-hz",
        type=float,
        default=80.0,
        help="Maximum Matplotlib redraw rate while plotting.",
    )
    parser.add_argument(
        "--plot-absolute",
        action="store_true",
        help="Plot absolute X^2+Y^2+Z^2 instead of baseline-subtracted change.",
    )
    parser.add_argument(
        "--plot-counts2",
        action="store_true",
        help="Plot delta counts^2 instead of normalized baseline-relative change.",
    )
    parser.add_argument(
        "--quiet",
        action="store_true",
        help="Do not print parsed samples to the terminal.",
    )
    args = parser.parse_args()

    csv_file = None
    writer = None
    if args.csv:
        csv_file = open(args.csv, "w", newline="", encoding="utf-8")
        writer = csv.DictWriter(
            csv_file,
            fieldnames=["timestamp", "sensor", "x", "y", "z", "raw_line"],
            )
        writer.writeheader()

    live_plot = (
        LivePlot(
            args.plot_window,
            args.plot_absolute,
            normalize=not args.plot_absolute and not args.plot_counts2,
        )
        if args.plot
        else None
    )
    last_plot_update = 0.0
    last_csv_flush = time.time()
    last_status_print = time.time()
    parsed_count = 0
    plot_update_period = 1.0 / args.plot_update_hz if args.plot_update_hz > 0 else 0.0

    try:
        with serial.Serial(args.port, args.baud, timeout=1) as ser:
            print(f"Reading {args.port} at {args.baud} baud. Press Ctrl-C to stop.")

            while True:
                data = ser.readline()
                if not data:
                    continue

                line = data.decode("ascii", errors="replace").strip()
                if not line:
                    continue

                parsed = parse_line(line)

                should_print = not args.quiet and (not args.plot or args.print_raw)

                if should_print and (args.print_raw or parsed is None):
                    print(line)
                elif should_print and parsed is not None:
                    print(
                        f"S{parsed['sensor']} "
                        f"X={parsed['x']:6d} "
                        f"Y={parsed['y']:6d} "
                        f"Z={parsed['z']:6d}"
                    )

                if writer and parsed is not None:
                    writer.writerow(
                        {
                            "timestamp": time.time(),
                            "sensor": parsed["sensor"],
                            "x": parsed["x"],
                            "y": parsed["y"],
                            "z": parsed["z"],
                            "raw_line": parsed["raw_line"],
                        }
                    )

                    now = time.time()
                    if now - last_csv_flush > 0.5:
                        csv_file.flush()
                        last_csv_flush = now

                if live_plot and parsed is not None:
                    parsed_count += 1
                    live_plot.add_sample(parsed)
                    now = time.time()
                    if now - last_plot_update >= plot_update_period:
                        live_plot.update()
                        last_plot_update = now
                    if now - last_status_print >= 2.0:
                        print(f"plotting: parsed {parsed_count} samples")
                        last_status_print = now

    except KeyboardInterrupt:
        print("\nStopped.")
        return 0
    finally:
        if csv_file:
            csv_file.close()

    return 0


if __name__ == "__main__":
    raise SystemExit(main())
