ianwu0228/dc_lab_spring_2026/(commit log)

2026-06-01 add four sensors
2026-06-02 test for only one sensor:
2026-06-06 update to real sensor position
2026-06-13 fix H2 not shown problem
    [DE2_115.sv]
2026-06-15 add LUT construction (not yet test), and stepper motor control module
2026-06-16 3-sensor version
2026-06-17 45, 75 hz ok
2026-06-17 update arduino stepper motor code
2026-06-17 add motor control logic (python version)
    [h45_lut.csv, h75_lut.csv]
2026-06-17 add button detection
2026-06-17 update LUT
    [h45_lut.csv, h45_lut_old.csv, h75_lut.csv, h75_lut_old.csv]
2026-06-19 update for the final submission file
    [h45_lut.csv, h45_lut_old.csv, h75_lut.csv, h75_lut_old.csv]
